bquangDinh/telemetry-board-rework/telemetry-rusolar-rework.kicad_pcb

## KiCad design telemetry-rusolar-rework.kicad_pcb (2026-03-26)

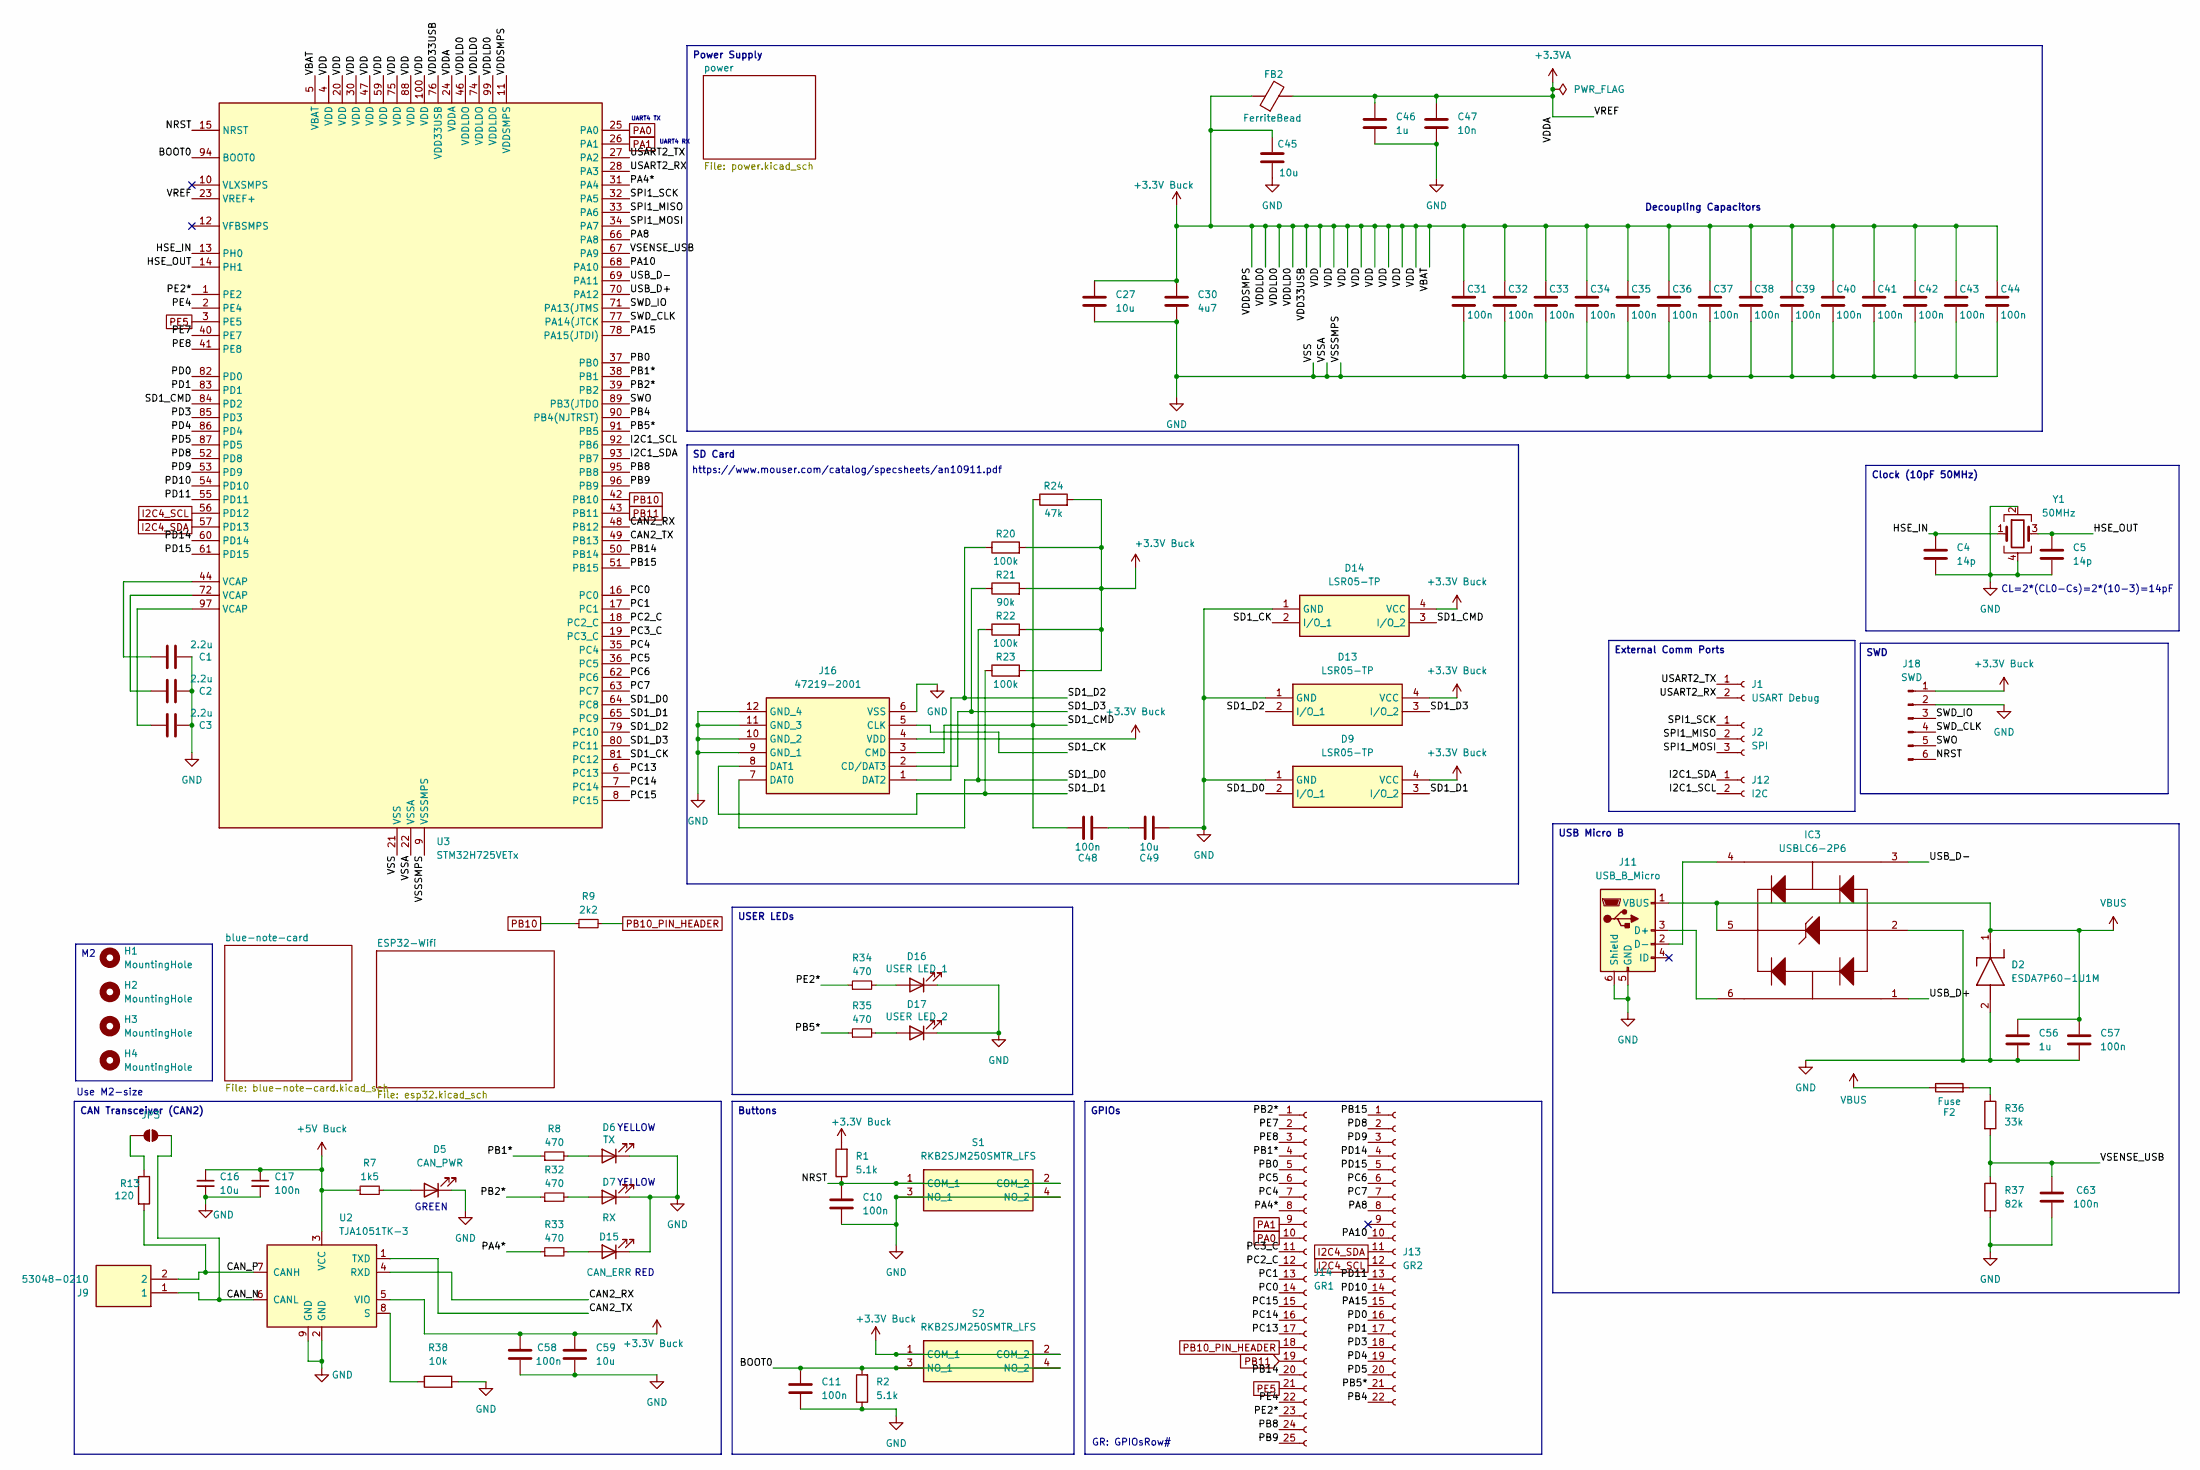
[picture p1: schematic telemetry-rusolar-rework.kicad_sch, Telemetry]

Parts:
C1, C2, C3: 2.2u; C_0805_2012Metric_Pad1.18x1.45mm_HandSolder
C4, C5: 14p; C_0603_1608Metric_Pad1.08x0.95mm_HandSolder
C10, C11, C17, C31, C32, C33, C34, C35, C36, C37, C38, C39, C40, C41, C42, C43, C44, C48, C57, C58, C63: 100n; C_0603_1608Metric_Pad1.08x0.95mm_HandSolder
C16, C27, C45, C49, C59: 10u; C_0805_2012Metric_Pad1.18x1.45mm_HandSolder
C30: 4u7; C_0805_2012Metric_Pad1.18x1.45mm_HandSolder
C46, C56: 1u; C_0805_2012Metric_Pad1.18x1.45mm_HandSolder
C47: 10n; C_0603_1608Metric_Pad1.08x0.95mm_HandSolder
D2: ESDA7P60-1U1M; ESDA7P601U1M; Mouser Part Number 511-ESDA7P60-1U1M
D5: CAN_PWR; LED_0805_2012Metric_Pad1.15x1.40mm_HandSolder
D6: TX; LED_0805_2012Metric_Pad1.15x1.40mm_HandSolder
D7: RX; LED_0805_2012Metric_Pad1.15x1.40mm_HandSolder
D9, D13, D14: LSR05-TP; LSR05TP; Mouser Part Number 833-LSR05-TP
D15: CAN_ERR; LED_0805_2012Metric_Pad1.15x1.40mm_HandSolder
D16: USER LED 1; LED_0805_2012Metric_Pad1.15x1.40mm_HandSolder
D17: USER LED 2; LED_0805_2012Metric_Pad1.15x1.40mm_HandSolder
F2: Fuse; Fuse_0603_1608Metric_Pad1.05x0.95mm_HandSolder
FB2: FerriteBead; L_0805_2012Metric_Pad1.15x1.40mm_HandSolder
H1, H2, H3, H4: MountingHole; MountingHole_2.2mm_M2
IC3: USBLC6-2P6; USBLC62P6; Mouser Part Number 511-USBLC6-2P6
J1: USART Debug; PinHeader_1x02_P2.00mm_Vertical
J2: SPI; PinHeader_1x03_P2.00mm_Vertical
J9: 53048-0210; SHDRRA2W35P0X125_1X2_425X550X350P; Mouser Part Number 538-53048-0210
J11: USB_B_Micro; USB_Micro-B_Wuerth_629105150521
J12: I2C; PinHeader_1x02_P2.00mm_Vertical
J13: GR2; PinSocket_1x22_P2.00mm_Vertical
J14: GR1; PinSocket_1x25_P2.00mm_Vertical
J16: 47219-2001; 472192001; Mouser Part Number 538-47219-2001
J18: SWD; PinHeader_1x06_P2.00mm_Vertical
JP3: SolderJumper_2_Open; SolderJumper-2_P1.3mm_Open_RoundedPad1.0x1.5mm
R1, R2: 5.1k; R_0603_1608Metric_Pad0.98x0.95mm_HandSolder
R7: 1k5; R_0603_1608Metric_Pad0.98x0.95mm_HandSolder
R8, R32, R33, R34, R35: 470; R_0603_1608Metric_Pad0.98x0.95mm_HandSolder
R9: 2k2; R_0603_1608Metric_Pad0.98x0.95mm_HandSolder
R13: 120; R_0603_1608Metric_Pad0.98x0.95mm_HandSolder
R20, R22, R23: 100k; R_0805_2012Metric_Pad1.20x1.40mm_HandSolder
R21: 90k; R_0805_2012Metric_Pad1.20x1.40mm_HandSolder
R24: 47k; R_0805_2012Metric_Pad1.20x1.40mm_HandSolder
R36: 33k; R_0603_1608Metric_Pad0.98x0.95mm_HandSolder
R37: 82k; R_0603_1608Metric_Pad0.98x0.95mm_HandSolder
R38: 10k; R_0603_1608Metric_Pad0.98x0.95mm_HandSolder
S1, S2: RKB2SJM250SMTR_LFS; RKB2SJM250SMTRLFS; Mouser Part Number 611-RKB2SJM250SMTRLF
U2: TJA1051TK-3; DFN-8-1EP_3x3mm_P0.65mm_EP1.55x2.4mm
U3: STM32H725VETx; LQFP-100_14x14mm_P0.5mm
Y1: 50MHz; Crystal_SMD_3225-4Pin_3.2x2.5mm

Connections:
+3.3V Buck: C27.2, C30.2, C31.1, C32.1, C33.1, C34.1, C35.1, C36.1, C37.1, C38.1, C39.1, C40.1, C41.1, C42.1, C43.1, C44.1, C45.2, C58.2, C59.2, D9.4 (VCC), D13.4 (VCC), D14.4 (VCC), FB2.1, J16.4 (VDD), J18.1, R1.2, R20.2, R21.2, R22.2, R23.2, R24.2, S2.1 (COM_1), S2.2 (COM_2), U2.5 (VIO), U3.4 (VDD), U3.5 (VBAT), U3.11 (VDDSMPS), U3.20 (VDD), U3.30 (VDD), U3.46 (VDDLDO), U3.47 (VDD), U3.59 (VDD), U3.74 (VDDLDO), U3.75 (VDD), U3.76 (VDD33USB), U3.88 (VDD), U3.99 (VDDLDO), U3.100 (VDD); also elsewhere on the board
+3.3VA: C46.2, C47.2, FB2.2, U3.23 (VREF+), U3.24 (VDDA)
+5V Buck: C16.1, C17.1, R7.1, U2.3 (VCC); also elsewhere on the board
/BOOT0: C11.1, R2.2, S2.3 (NO_1), S2.4 (NO_2), U3.94 (BOOT0)
/CAN2_RX: U2.4 (RXD), U3.48 (PB12)
/CAN2_TX: U2.1 (TXD), U3.49 (PB13)
/CAN_N: J9.1, JP3.2 (B), U2.6 (CANL)
/CAN_P: J9.2, R13.2, U2.7 (CANH)
/HSE_IN: C4.1, U3.13 (PH0), Y1.1
/HSE_OUT: C5.1, U3.14 (PH1), Y1.3
/I2C1_SCL: J12.2, U3.92 (PB6)
/I2C1_SDA: J12.1, U3.93 (PB7)
/NRST: C10.1, J18.6, R1.1, S1.1 (COM_1), S1.2 (COM_2), U3.15 (NRST)
/PA4*: J14.8, R33.1, U3.31 (PA4)
/PA8: J13.8, U3.66 (PA8)
/PA10: J13.10, U3.68 (PA10)
/PA15: J13.15, U3.78 (PA15(JTDI))
/PB0: J14.5, U3.37 (PB0)
/PB1*: J14.4, R8.1, U3.38 (PB1)
/PB2*: J14.1, R32.1, U3.39 (PB2)
/PB4: J13.22, U3.90 (PB4(NJTRST))
/PB5*: J13.21, R35.1, U3.91 (PB5)
/PB8: J14.24, U3.95 (PB8)
/PB9: J14.25, U3.96 (PB9)
/PB14: J14.20, U3.50 (PB14)
/PB15: J13.1, U3.51 (PB15)
/PC0: J14.14, U3.16 (PC0)
/PC1: J14.13, U3.17 (PC1)
/PC2_C: J14.12, U3.18 (PC2_C)
/PC3_C: J14.11, U3.19 (PC3_C)
/PC4: J14.7, U3.35 (PC4)
/PC5: J14.6, U3.36 (PC5)
/PC6: J13.6, U3.62 (PC6)
/PC7: J13.7, U3.63 (PC7)
/PC13: J14.17, U3.6 (PC13)
/PC14: J14.16, U3.7 (PC14)
/PC15: J14.15, U3.8 (PC15)
/PD0: J13.16, U3.82 (PD0)
/PD1: J13.17, U3.83 (PD1)
/PD3: J13.18, U3.85 (PD3)
/PD4: J13.19, U3.86 (PD4)
/PD5: J13.20, U3.87 (PD5)
/PD8: J13.2, U3.52 (PD8)
/PD9: J13.3, U3.53 (PD9)
/PD10: J13.14, U3.54 (PD10)
/PD11: J13.13, U3.55 (PD11)
/PD14: J13.4, U3.60 (PD14)
/PD15: J13.5, U3.61 (PD15)
/PE2*: J14.23, R34.1, U3.1 (PE2)
/PE4: J14.22, U3.2 (PE4)
/PE7: J14.2, U3.40 (PE7)
/PE8: J14.3, U3.41 (PE8)
/SD1_CK: D14.2 (I/O_1), J16.5 (CLK), U3.81 (PC12)
/SD1_CMD: C48.1, D14.3 (I/O_2), J16.3 (CMD), R24.1, U3.84 (PD2)
/SD1_D0: D9.2 (I/O_1), J16.7 (DAT0), R22.1, U3.64 (PC8)
/SD1_D1: D9.3 (I/O_2), J16.8 (DAT1), R23.1, U3.65 (PC9)
/SD1_D2: D13.2 (I/O_1), J16.1 (DAT2), R20.1, U3.79 (PC10)
/SD1_D3: D13.3 (I/O_2), J16.2 (CD/DAT3), R21.1, U3.80 (PC11)
/SPI1_MISO: J2.2, U3.33 (PA6)
/SPI1_MOSI: J2.3, U3.34 (PA7)
/SPI1_SCK: J2.1, U3.32 (PA5)
/SWD_CLK: J18.4, U3.77 (PA14(JTCK)
/SWD_IO: J18.3, U3.71 (PA13(JTMS)
/SWO: J18.5, U3.89 (PB3(JTDO)
/USART2_RX: J1.2, U3.28 (PA3)
/USART2_TX: J1.1, U3.27 (PA2)
/USB_D+: IC3.1 (I/O1_1), U3.70 (PA12)
/USB_D-: IC3.3 (I/O2_1), U3.69 (PA11)
/VSENSE_USB: C63.1, R36.2, R37.1, U3.67 (PA9)
GND: C1.1, C2.1, C3.1, C4.2, C5.2, C10.2, C11.2, C16.2, C17.2, C27.1, C30.1, C31.2, C32.2, C33.2, C34.2, C35.2, C36.2, C37.2, C38.2, C39.2, C40.2, C41.2, C42.2, C43.2, C44.2, C45.1, C46.1, C47.1, C49.2, C56.2, C57.2, C58.1, C59.1, C63.2, D2.2 (A), D5.1 (K), D6.1 (K), D7.1 (K), D9.1 (GND), D13.1 (GND), D14.1 (GND), D15.1 (K), D16.1 (K), D17.1 (K), IC3.2 (GND), J11.5 (GND), J11.6 (Shield), J16.6 (VSS), J16.9 (GND_1), J16.10 (GND_2), J16.11 (GND_3), J16.12 (GND_4), J18.2, R2.1, R37.2, R38.2, S1.3 (NO_1), S1.4 (NO_2), U2.2 (GND), U2.9 (GND), U3.9 (VSSSMPS), U3.21 (VSS), U3.22 (VSSA), U3.29 (VSS), U3.45 (VSS), U3.58 (VSS), U3.73 (VSS), U3.98 (VSS), Y1.2, Y1.4; also elsewhere on the board
I2C4_SCL: J13.12, U3.56 (PD12); also elsewhere on the board
I2C4_SDA: J13.11, U3.57 (PD13); also elsewhere on the board
unnamed: C1.2, U3.44 (VCAP)
unnamed: C2.2, U3.72 (VCAP)
unnamed: C3.2, U3.97 (VCAP)
unnamed: C48.2, C49.1
unnamed: D5.2 (A), R7.2
unnamed: D6.2 (A), R8.2
unnamed: D7.2 (A), R32.2
unnamed: D15.2 (A), R33.2
unnamed: D16.2 (A), R34.2
unnamed: D17.2 (A), R35.2
unnamed: F2.2, R36.1
unnamed: IC3.6 (I/O1_2), J11.3 (D+)
unnamed: IC3.4 (I/O2_2), J11.2 (D-)
unnamed: JP3.1 (A), R13.1
unnamed: R38.1, U2.8 (S)
PA0: J14.10, U3.25 (PA0); also elsewhere on the board
PA1: J14.9, U3.26 (PA1); also elsewhere on the board
PB10: R9.1, U3.42 (PB10)
PB10_PIN_HEADER: J14.18, R9.2; also elsewhere on the board
PB11: J14.19, U3.43 (PB11); also elsewhere on the board
PE5: J14.21, U3.3 (PE5); also elsewhere on the board
VBUS: C56.1, C57.1, D2.1 (K), F2.1, IC3.5 (VBUS), J11.1 (VBUS)

Notes on the sheet:
RED
UART4 TX
https://www.mouser.com/catalog/specsheets/an10911.pdf
Use M2-size
GREEN
CL=2*(CL0-Cs)=2*(10-3)=14pF
UART4 RX
YELLOW
Decoupling Capacitors
GR: GPIOsRow#
SD Card
Buttons
USER LEDs
Clock (10pF 50MHz)
Power Supply
SWD
USB Micro B
GPIOs
CAN Transceiver (CAN2)
External Comm Ports

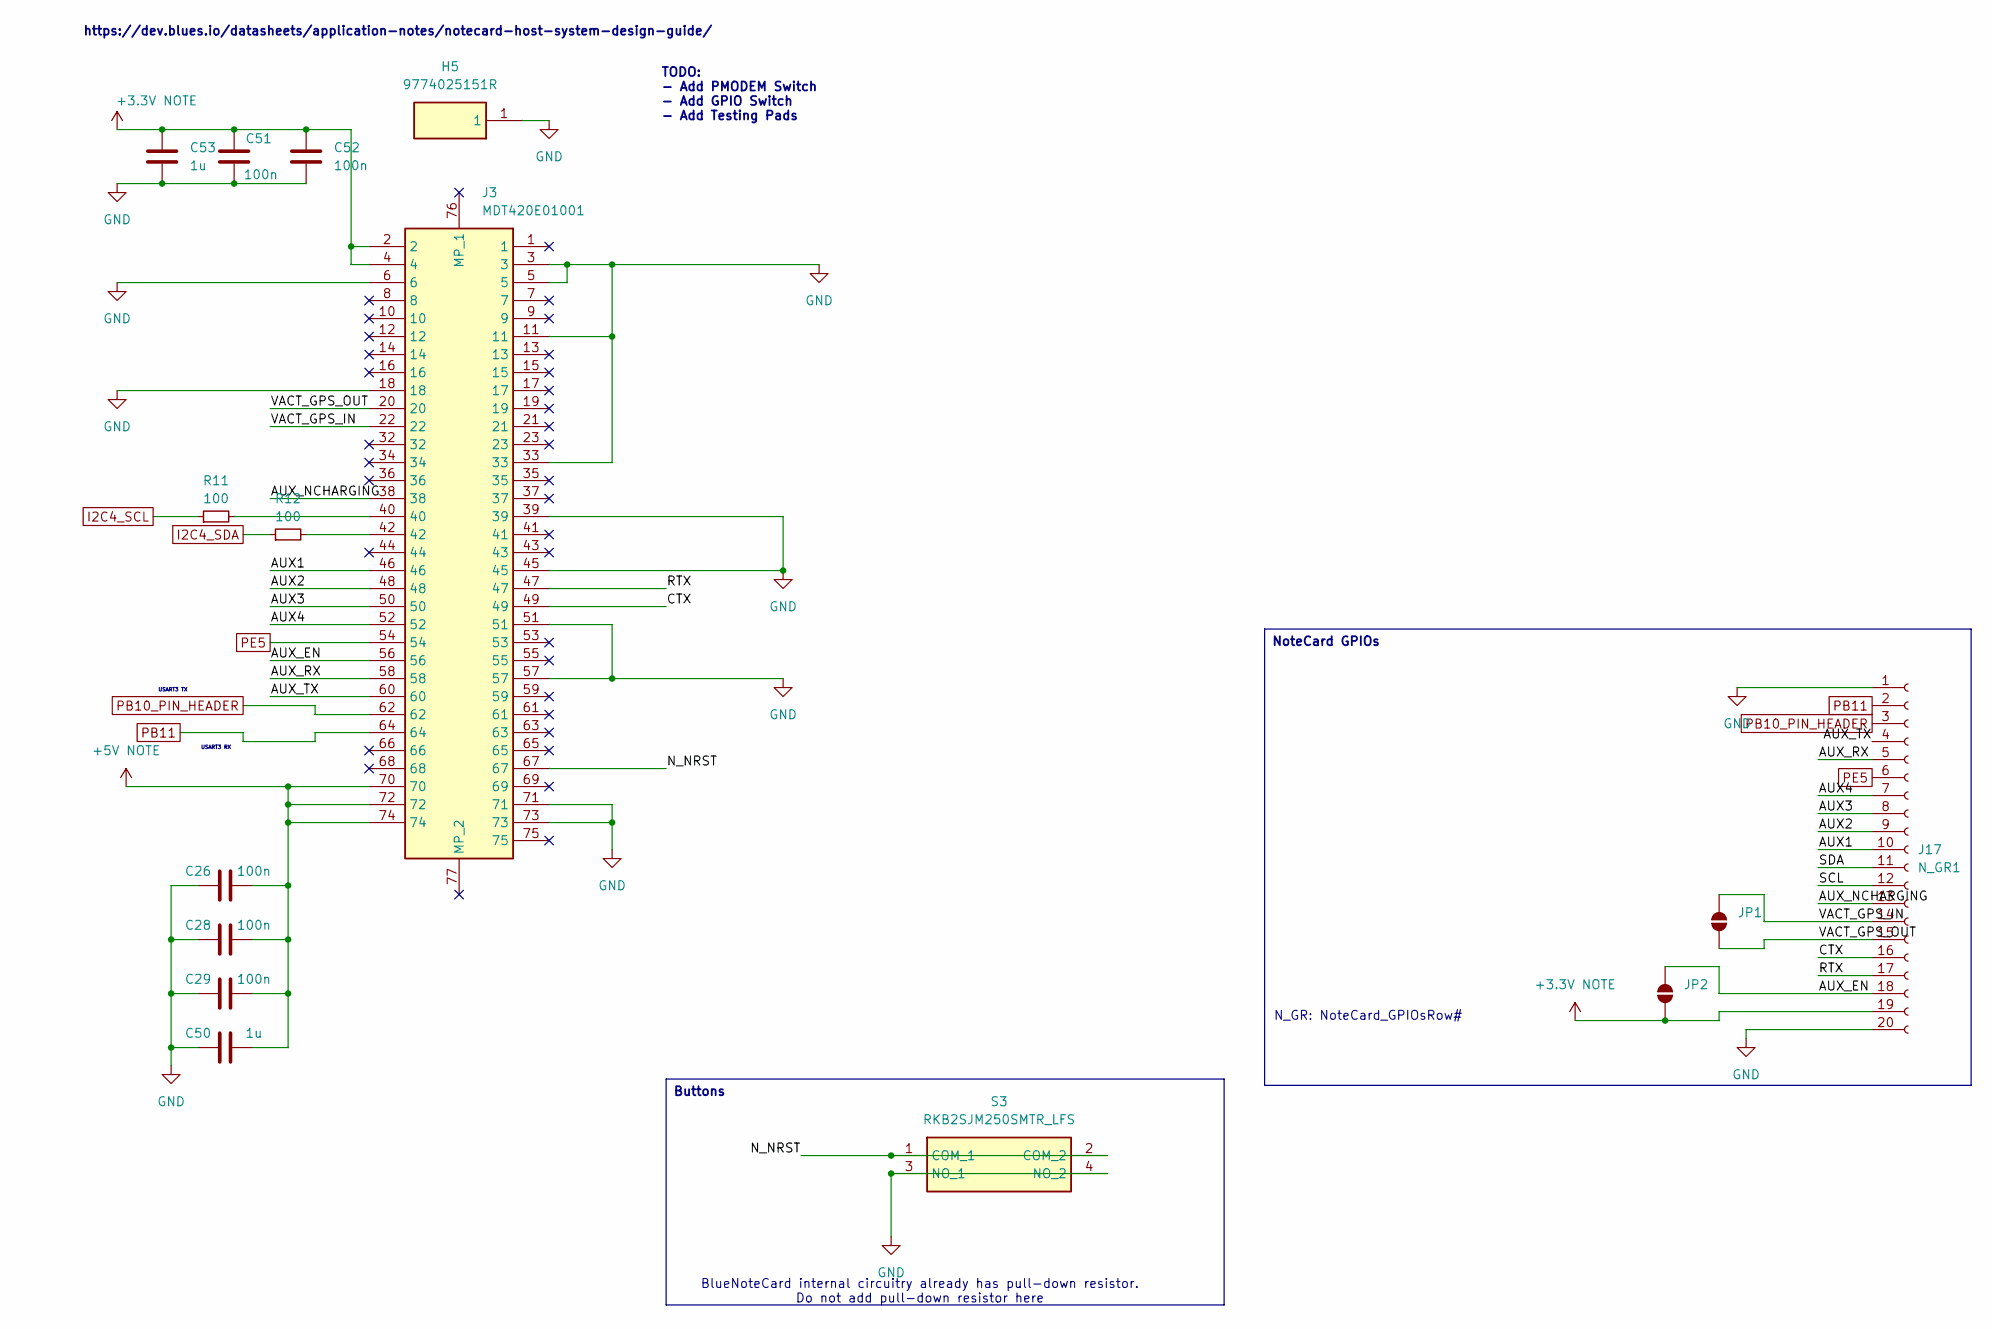
[picture p2: schematic blue-note-card.kicad_sch, Blue Note Card]

Parts:
C26, C28, C29, C51, C52: 100n; C_0603_1608Metric_Pad1.08x0.95mm_HandSolder
C50, C53: 1u; C_0805_2012Metric_Pad1.18x1.45mm_HandSolder
H5: 9774025151R; Mouser Part Number 710-9774025151R
J3: MDT420E01001; Mouser Part Number 523-MDT420E01001
J17: N_GR1; PinSocket_1x20_P2.00mm_Vertical
JP1, JP2: SolderJumper_2_Open; SolderJumper-2_P1.3mm_Open_RoundedPad1.0x1.5mm
R11, R12: 100; R_0603_1608Metric_Pad0.98x0.95mm_HandSolder
S3: RKB2SJM250SMTR_LFS; RKB2SJM250SMTRLFS; Mouser Part Number 611-RKB2SJM250SMTRLF

Connections:
+3.3V NOTE: C51.2, C52.2, C53.2, J3.2, J3.4, J17.19, JP2.2 (B); also elsewhere on the board
+5V NOTE: C26.2, C28.2, C29.2, C50.2, J3.70, J3.72, J3.74; also elsewhere on the board
/blue-note-card/AUX1: J3.46, J17.10
/blue-note-card/AUX2: J3.48, J17.9
/blue-note-card/AUX3: J3.50, J17.8
/blue-note-card/AUX4: J3.52, J17.7
/blue-note-card/AUX_EN: J3.56, J17.18, JP2.1 (A)
/blue-note-card/AUX_NCHARGING: J3.38, J17.13
/blue-note-card/AUX_RX: J3.58, J17.5
/blue-note-card/AUX_TX: J3.60, J17.4
/blue-note-card/CTX: J3.49, J17.16
/blue-note-card/N_NRST: J3.67, S3.1 (COM_1), S3.2 (COM_2)
/blue-note-card/RTX: J3.47, J17.17
/blue-note-card/SCL: J17.12
/blue-note-card/SDA: J17.11
/blue-note-card/VACT_GPS_IN: J3.22, J17.14, JP1.1 (A)
/blue-note-card/VACT_GPS_OUT: J3.20, J17.15, JP1.2 (B)
GND: C26.1, C28.1, C29.1, C50.1, C51.1, C52.1, C53.1, H5.1, J3.3, J3.5, J3.6, J3.11, J3.18, J3.33, J3.39, J3.45, J3.51, J3.57, J3.71, J3.73, J17.1, J17.20, S3.3 (NO_1), S3.4 (NO_2); also elsewhere on the board
I2C4_SCL: R11.1; also elsewhere on the board
I2C4_SDA: R12.1; also elsewhere on the board
unnamed: J3.40, R11.2
unnamed: J3.42, R12.2
PB10_PIN_HEADER: J3.62, J17.3; also elsewhere on the board
PB11: J3.64, J17.2; also elsewhere on the board
PE5: J3.54, J17.6; also elsewhere on the board

Notes on the sheet:
TODO: - Add PMODEM Switch - Add GPIO Switch - Add Testing Pads
BlueNoteCard internal circuitry already has pull-down resistor. Do not add pull-down resistor here
https://dev.blues.io/datasheets/application-notes/notecard-host-system-design-guide/
N_GR: NoteCard_GPIOsRow#
USART3 RX
USART3 TX
Buttons
NoteCard GPIOs

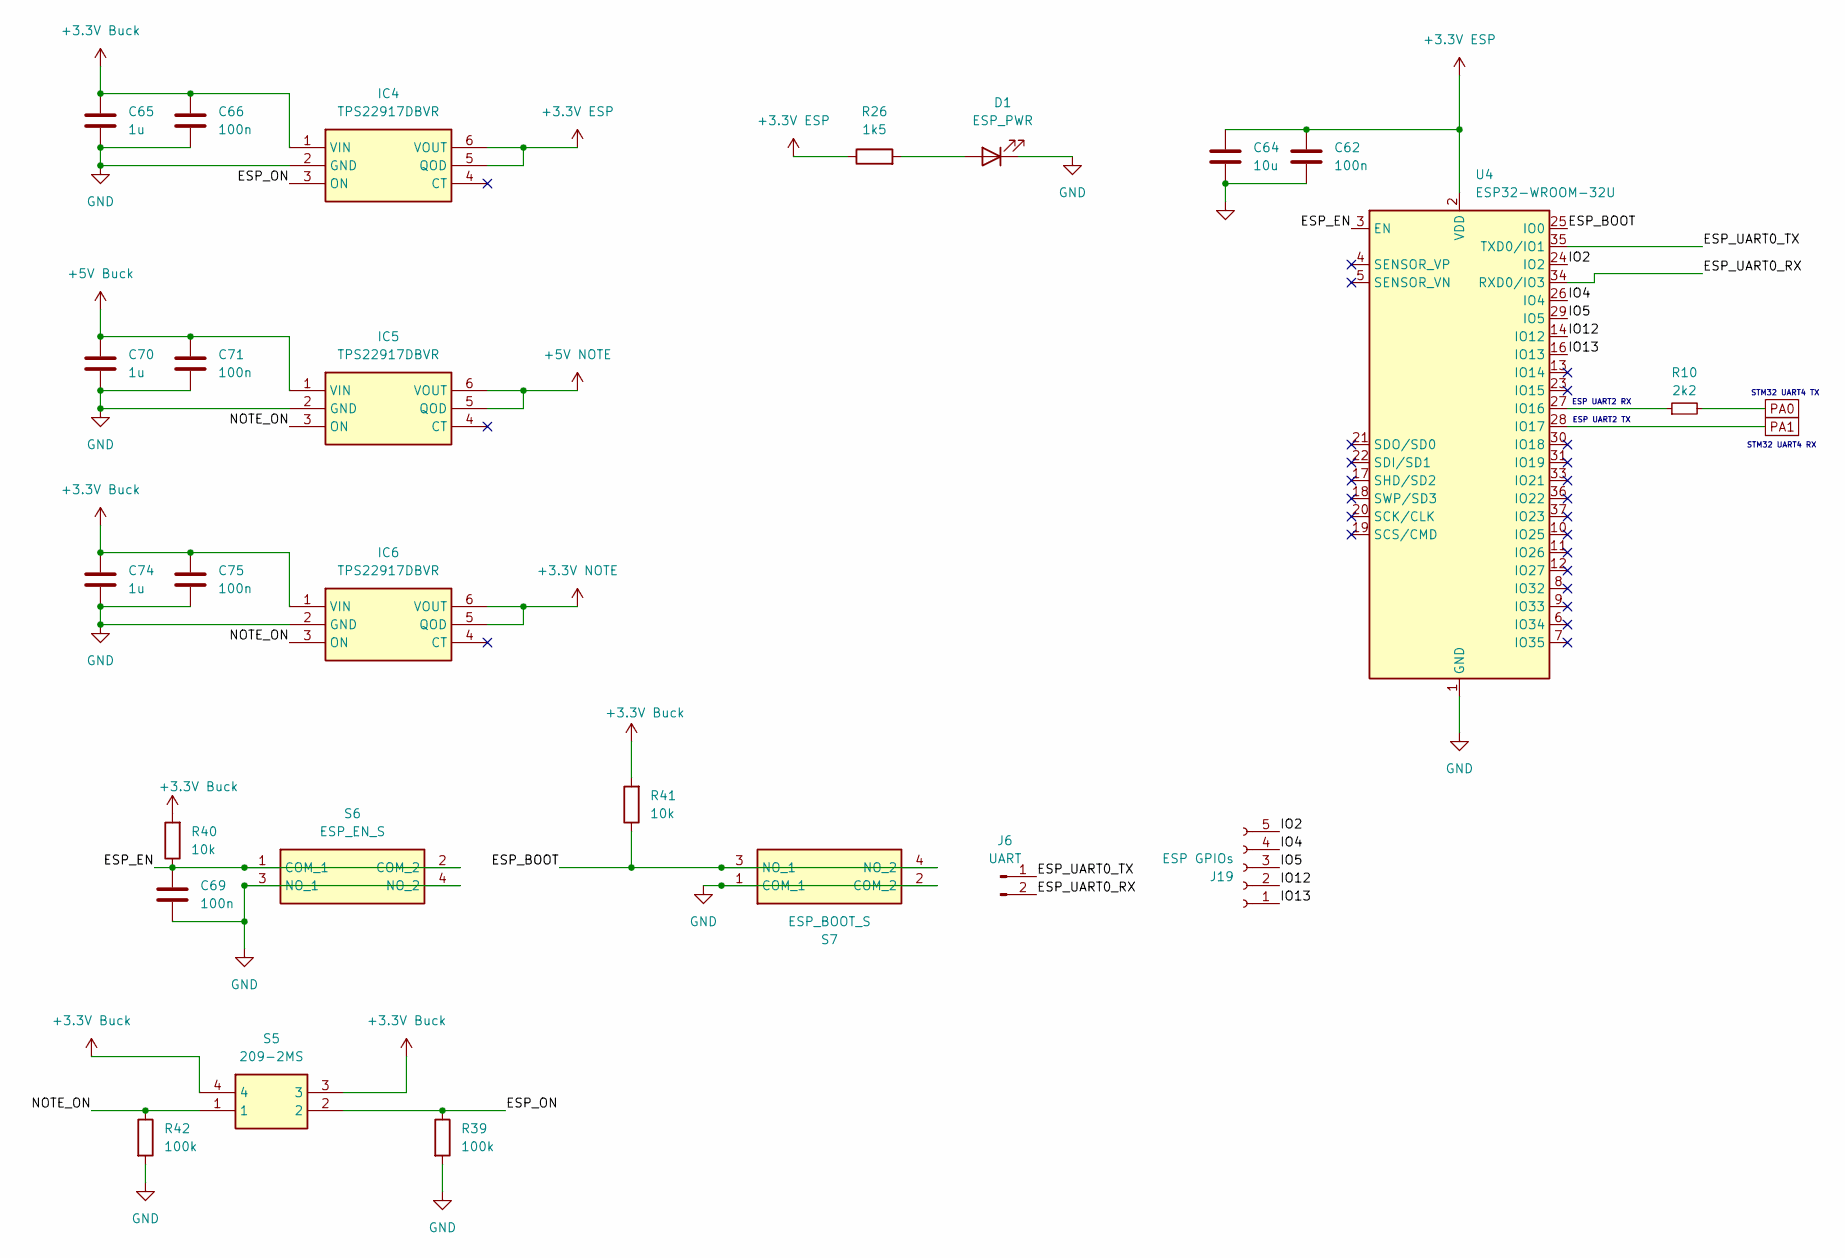
[picture p3: schematic esp32.kicad_sch]

Parts:
C62, C66, C69, C71, C75: 100n; C_0603_1608Metric_Pad1.08x0.95mm_HandSolder
C64: 10u; C_0805_2012Metric_Pad1.18x1.45mm_HandSolder
C65, C70, C74: 1u; C_0805_2012Metric_Pad1.18x1.45mm_HandSolder
D1: ESP_PWR; LED_0805_2012Metric_Pad1.15x1.40mm_HandSolder
IC4, IC5, IC6: TPS22917DBVR; SOT95P280X145-6N; Mouser Part Number 595-TPS22917DBVR
J6: UART; PinHeader_1x02_P2.00mm_Vertical
J19: ESP GPIOs; PinSocket_1x05_P2.00mm_Vertical
R10: 2k2; R_0603_1608Metric_Pad0.98x0.95mm_HandSolder
R26: 1k5; R_0603_1608Metric_Pad0.98x0.95mm_HandSolder
R39, R42: 100k; R_0805_2012Metric_Pad1.20x1.40mm_HandSolder
R40, R41: 10k; R_0603_1608Metric_Pad0.98x0.95mm_HandSolder
S5: 209-2MS; 2092MS; Mouser Part Number 774-2092MS
S6: ESP_EN_S; RKB2SJM250SMTRLFS; Mouser Part Number 611-RKB2SJM250SMTRLF
S7: ESP_BOOT_S; RKB2SJM250SMTRLFS; Mouser Part Number 611-RKB2SJM250SMTRLF
U4: ESP32-WROOM-32U

Connections:
+3.3V Buck: C65.1, C66.1, C74.1, C75.1, IC4.1 (VIN), IC6.1 (VIN), R40.2, R41.2, S5.3, S5.4; also elsewhere on the board
+3.3V ESP: C62.1, C64.1, IC4.5 (QOD), IC4.6 (VOUT), R26.1, U4.2 (VDD)
+3.3V NOTE: IC6.5 (QOD), IC6.6 (VOUT); also elsewhere on the board
+5V Buck: C70.1, C71.1, IC5.1 (VIN); also elsewhere on the board
+5V NOTE: IC5.5 (QOD), IC5.6 (VOUT); also elsewhere on the board
/ESP32-Wifi/ESP_BOOT: R41.1, S7.3 (NO_1), S7.4 (NO_2), U4.25 (IO0)
/ESP32-Wifi/ESP_EN: C69.1, R40.1, S6.1 (COM_1), S6.2 (COM_2), U4.3 (EN)
/ESP32-Wifi/ESP_ON: IC4.3 (ON), R39.1, S5.2
/ESP32-Wifi/ESP_UART0_RX: J6.2, U4.34 (RXD0/IO3)
/ESP32-Wifi/ESP_UART0_TX: J6.1, U4.35 (TXD0/IO1)
/ESP32-Wifi/IO2: J19.5, U4.24 (IO2)
/ESP32-Wifi/IO4: J19.4, U4.26 (IO4)
/ESP32-Wifi/IO5: J19.3, U4.29 (IO5)
/ESP32-Wifi/IO12: J19.2, U4.14 (IO12)
/ESP32-Wifi/IO13: J19.1, U4.16 (IO13)
/ESP32-Wifi/NOTE_ON: IC5.3 (ON), IC6.3 (ON), R42.1, S5.1
GND: C62.2, C64.2, C65.2, C66.2, C69.2, C70.2, C71.2, C74.2, C75.2, D1.1 (K), IC4.2 (GND), IC5.2 (GND), IC6.2 (GND), R39.2, R42.2, S6.3 (NO_1), S6.4 (NO_2), S7.1 (COM_1), S7.2 (COM_2), U4.1 (GND), U4.15 (GND), U4.38 (GND), U4.39 (GND); also elsewhere on the board
unnamed: D1.2 (A), R26.2
unnamed: R10.1, U4.27 (IO16)
PA0: R10.2; also elsewhere on the board
PA1: U4.28 (IO17); also elsewhere on the board

Notes on the sheet:
STM32 UART4 TX
STM32 UART4 RX
ESP UART2 RX
ESP UART2 TX

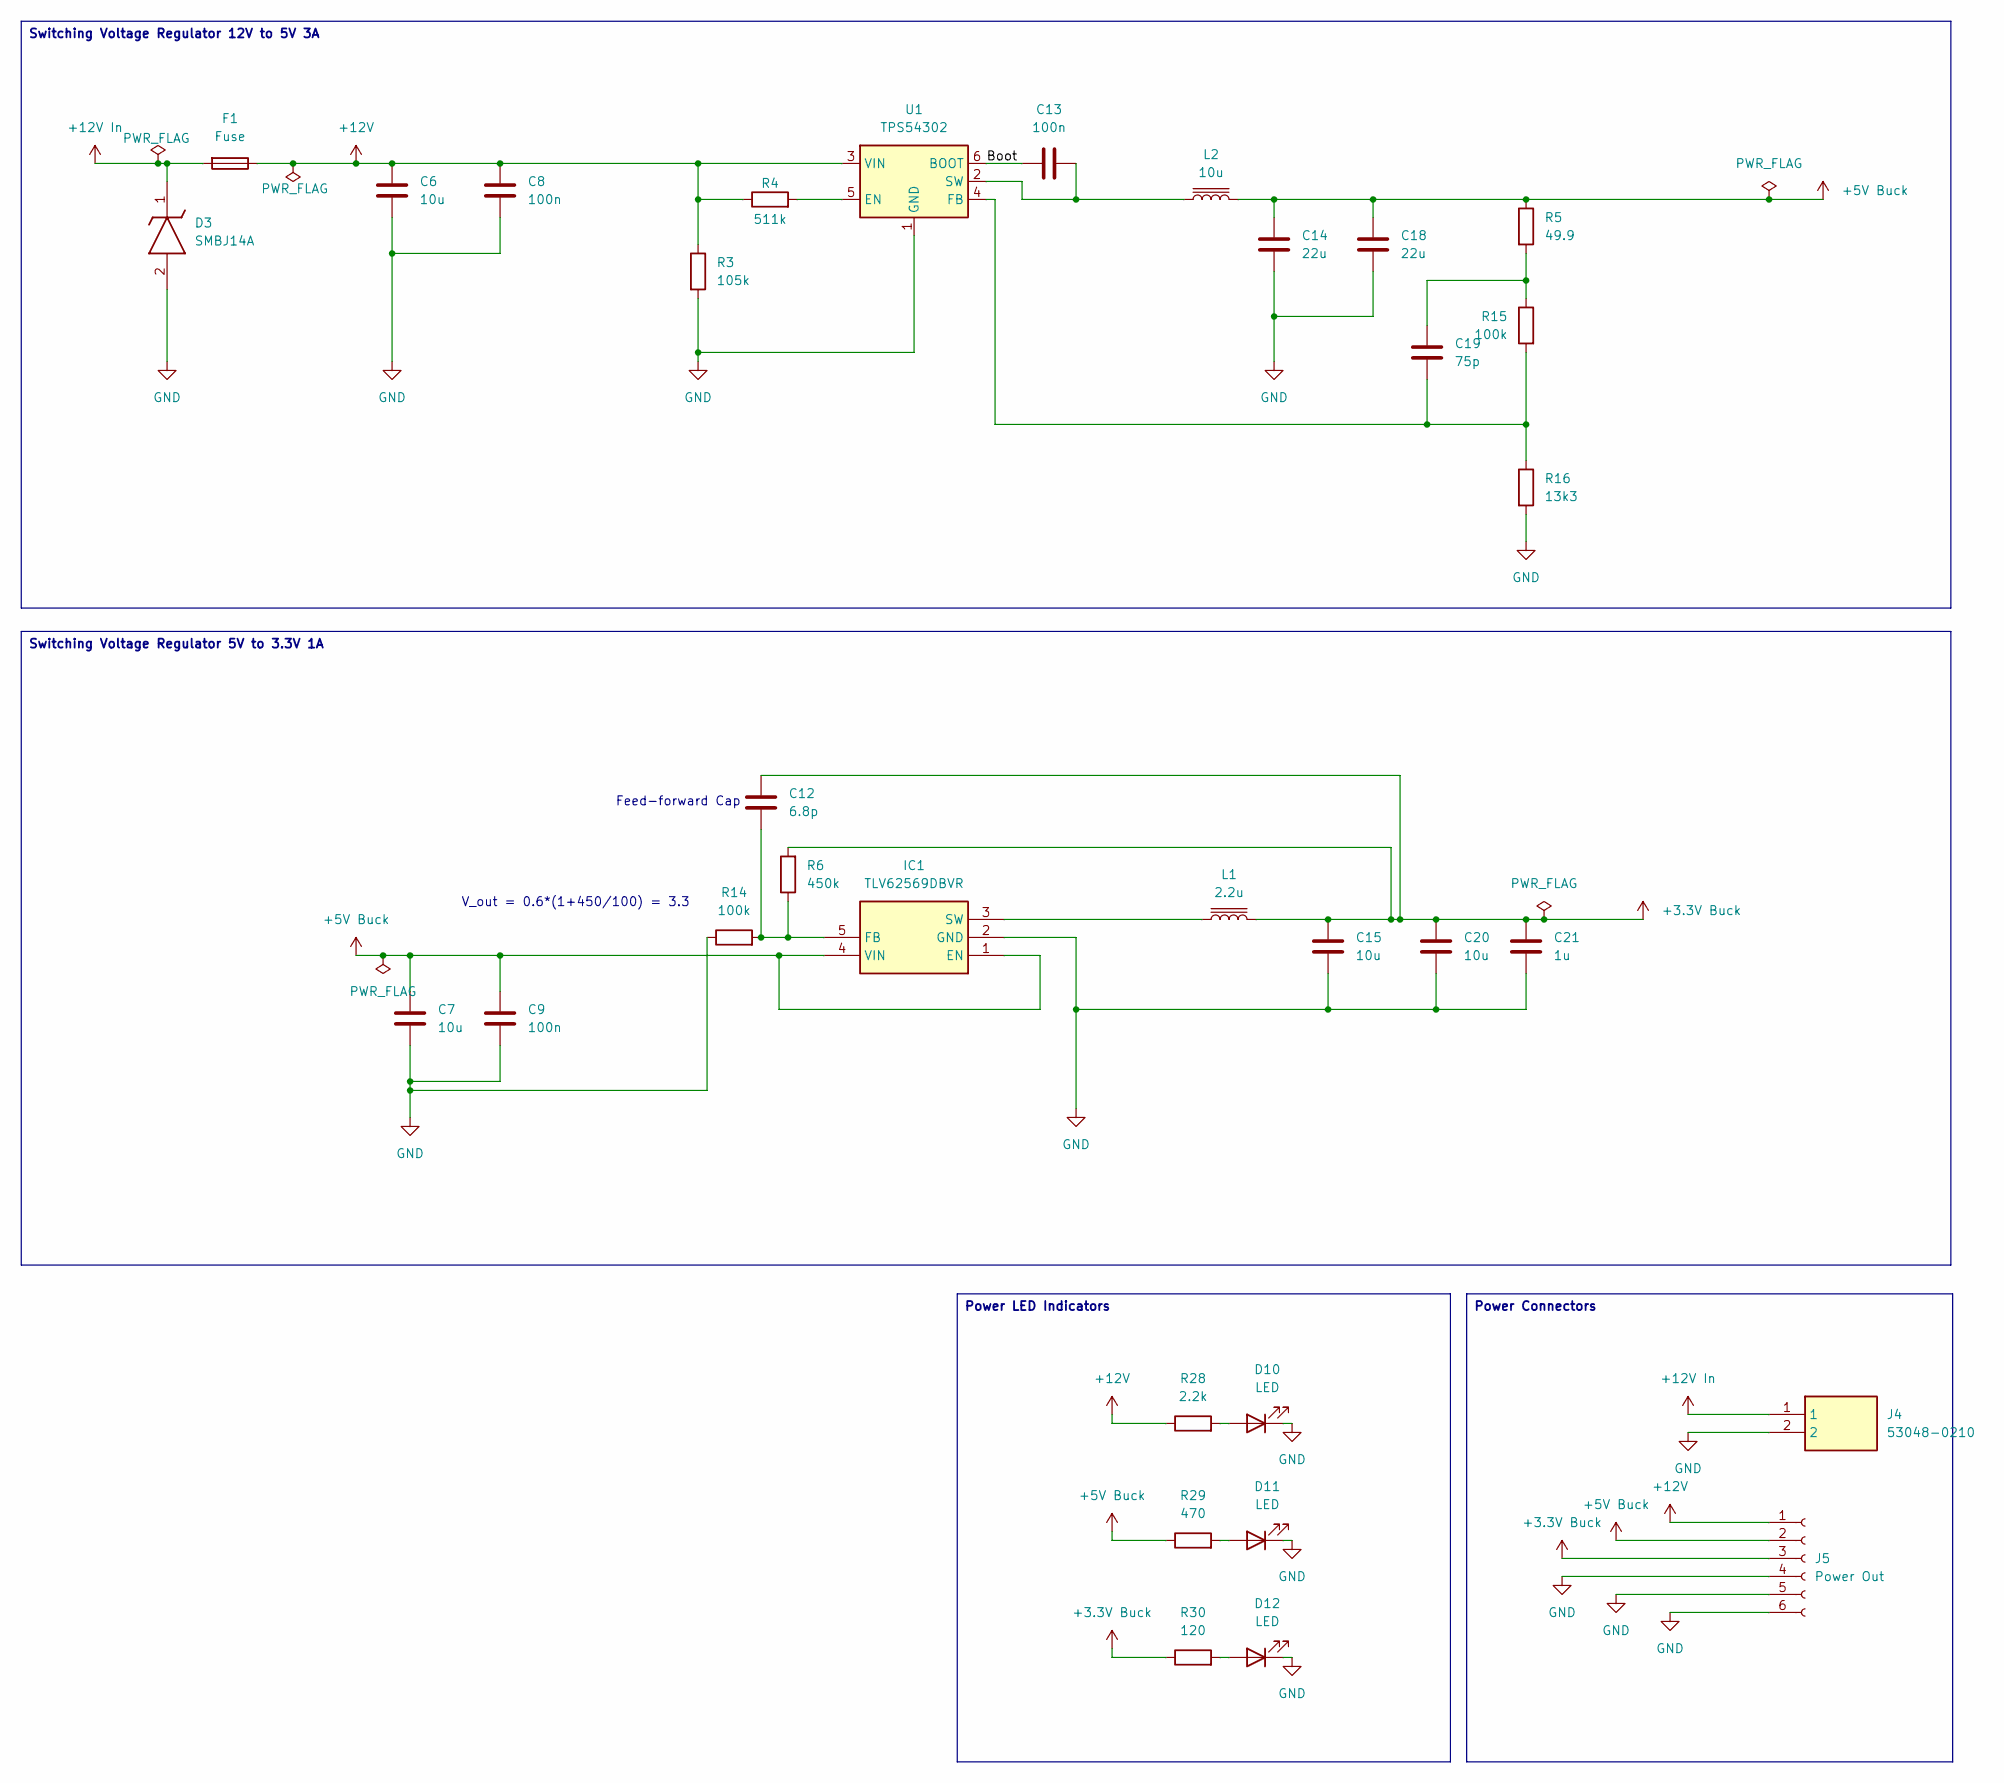
[picture p4: schematic power.kicad_sch, Power Supply]

Parts:
C6, C7, C15, C20: 10u; C_0805_2012Metric_Pad1.18x1.45mm_HandSolder
C8, C9, C13: 100n; C_0603_1608Metric_Pad1.08x0.95mm_HandSolder
C12: 6.8p; C_0805_2012Metric_Pad1.18x1.45mm_HandSolder
C14, C18: 22u; C_1210_3225Metric_Pad1.33x2.70mm_HandSolder
C19: 75p; C_0603_1608Metric_Pad1.08x0.95mm_HandSolder
C21: 1u; C_0805_2012Metric_Pad1.18x1.45mm_HandSolder
D3: SMBJ14A; DIOM5436X261N; Mouser Part Number 576-SMBJ14A
D10, D11, D12: LED; LED_0805_2012Metric_Pad1.15x1.40mm_HandSolder
F1: Fuse; Fuseholder_Blade_Mini_Keystone_3568
IC1: TLV62569DBVR; SOT95P280X145-5N; Mouser Part Number 595-TLV62569DBVR
J4: 53048-0210; SHDRRA2W35P0X125_1X2_425X550X350P; Mouser Part Number 538-53048-0210
J5: Power Out; PinSocket_1x06_P2.00mm_Vertical
L1: 2.2u; LQM2HPZ3R3MJ0B
L2: 10u; INDPM6965X300N
R3: 105k; R_0805_2012Metric_Pad1.20x1.40mm_HandSolder
R4: 511k; R_0805_2012Metric_Pad1.20x1.40mm_HandSolder
R5: 49.9; R_0805_2012Metric_Pad1.20x1.40mm_HandSolder
R6: 450k; R_0805_2012Metric_Pad1.20x1.40mm_HandSolder
R14, R15: 100k; R_0805_2012Metric_Pad1.20x1.40mm_HandSolder
R16: 13k3; R_0805_2012Metric_Pad1.20x1.40mm_HandSolder
R28: 2.2k; R_0603_1608Metric_Pad0.98x0.95mm_HandSolder
R29: 470; R_0603_1608Metric_Pad0.98x0.95mm_HandSolder
R30: 120; R_0603_1608Metric_Pad0.98x0.95mm_HandSolder
U1: TPS54302; SOT-23-6

Connections:
+3.3V Buck: C12.2, C15.1, C20.1, C21.1, J5.3, L1.2, R6.2, R30.1; also elsewhere on the board
+5V Buck: C7.2, C9.1, C14.1, C18.1, IC1.1 (EN), IC1.4 (VIN), J5.2, L2.2, R5.1, R29.1; also elsewhere on the board
+12V: C6.1, C8.1, F1.1, J5.1, R3.1, R4.1, R28.1, U1.3 (VIN)
+12V In: D3.1 (K), F1.2, J4.1
/power/Boot: C13.1, U1.6 (BOOT)
GND: C6.2, C7.1, C8.2, C9.2, C14.2, C15.2, C18.2, C20.2, C21.2, D3.2 (A), D10.1 (K), D11.1 (K), D12.1 (K), IC1.2 (GND), J4.2, J5.4, J5.5, J5.6, R3.2, R14.1, R16.2, U1.1 (GND); also elsewhere on the board
unnamed: C19.1, R5.2, R15.1
unnamed: D10.2 (A), R28.2
unnamed: D11.2 (A), R29.2
unnamed: D12.2 (A), R30.2
unnamed: C12.1, IC1.5 (FB), R6.1, R14.2
unnamed: IC1.3 (SW), L1.1
unnamed: R4.2, U1.5 (EN)
unnamed: C19.2, R15.2, R16.1, U1.4 (FB)
unnamed: C13.2, L2.1, U1.2 (SW)

Notes on the sheet:
Feed-forward Cap
V_out = 0.6*(1+450/100) = 3.3
Power Connectors
Power LED Indicators
Switching Voltage Regulator 5V to 3.3V 1A
Switching Voltage Regulator 12V to 5V 3A

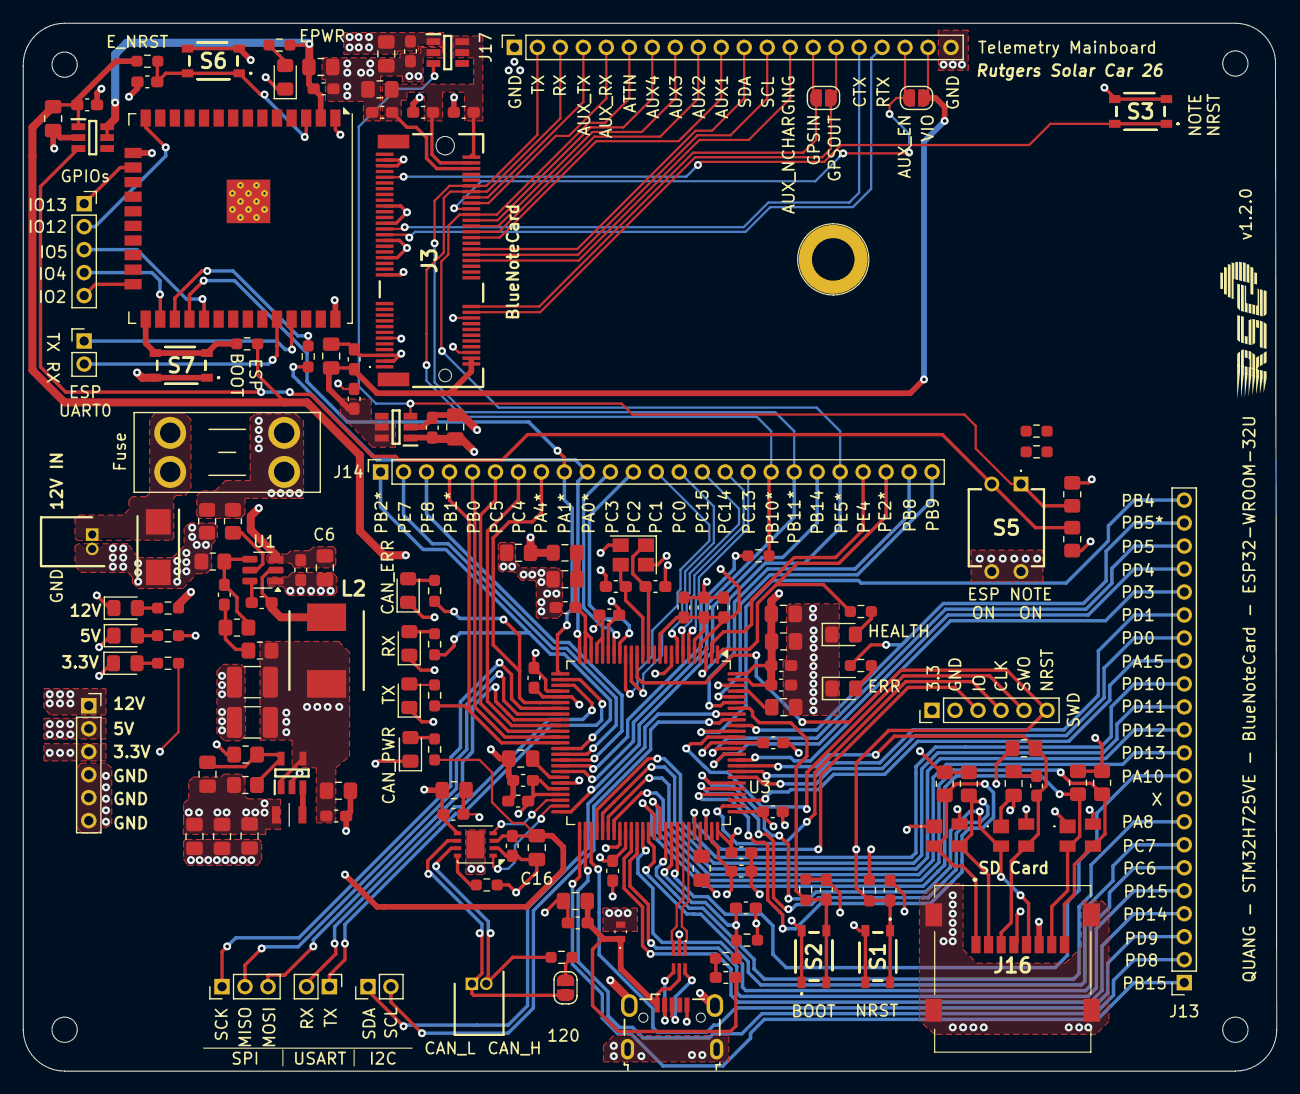
[picture p5: board telemetry-rusolar-rework.kicad_pcb from above]

Board: 4 copper layers, 109.1 x 91.2 mm, 158 parts (0 on the bottom side), 137 nets.
