bquangDinh/telemetry-board-rework/(commit log)

2025-12-02 Layout parts
    [blue-note-card.kicad_sch, telemetry-rusolar-rework.kicad_pcb, telemetry-rusolar-rework.kicad_sch]
2025-12-04 Fixed DRC errors
    [blue-note-card.kicad_sch, telemetry-rusolar-rework.kicad_pcb, telemetry-rusolar-rework.kicad_sch]
2025-12-04 Added ORing VBUS
    [blue-note-card.kicad_sch, power.kicad_sch, telemetry-rusolar-rework.kicad_pcb]
2025-12-04 Removed CAN TX/RX LED indicators
    [telemetry-rusolar-rework.kicad_pcb, telemetry-rusolar-rework.kicad_sch]
2025-12-05 Added LED indicators, USER LEDs, extended layout, fixed footprints
    [blue-note-card.kicad_sch, power.kicad_sch, telemetry-rusolar-rework.kicad_pcb, telemetry-rusolar-rework.kicad_sch]
2025-12-05 Relayout NanoSim component
    [blue-note-card.kicad_sch, telemetry-rusolar-rework.kicad_pcb]
2025-12-16 Added changes
    [blue-note-card.kicad_sch, power.kicad_sch, telemetry-rusolar-rework.kicad_pcb, telemetry-rusolar-rework.kicad_sch]
2026-02-15 Fixed USB VSENSE, fixed things
    [power.kicad_sch, telemetry-rusolar-rework.kicad_pcb, telemetry-rusolar-rework.kicad_sch]
2026-02-17 Fixed things
    [blue-note-card.kicad_sch, esp32.kicad_sch, power.kicad_sch, telemetry-rusolar-rework.kicad_pcb, telemetry-rusolar-rework.kicad_sch]
2026-02-18 Fixed a lot of things
    [esp32.kicad_sch, telemetry-rusolar-rework.kicad_pcb, telemetry-rusolar-rework.kicad_sch]
2026-03-14 Added temp
    [telemetry-rusolar-rework.kicad_pcb, telemetry-rusolar-rework.kicad_sch]
2026-03-26 Added AUX_EN, I2C com to Blues, LED labels
    [blue-note-card.kicad_sch, telemetry-rusolar-rework.kicad_pcb, telemetry-rusolar-rework.kicad_sch]
